TorchedVIP/Doom-Minibadge/gerbers/minibadge_doom/minibadge_doom.kicad_pcb

## KiCad design gerbers/minibadge_doom/minibadge_doom.kicad_pcb (2026-10-29)

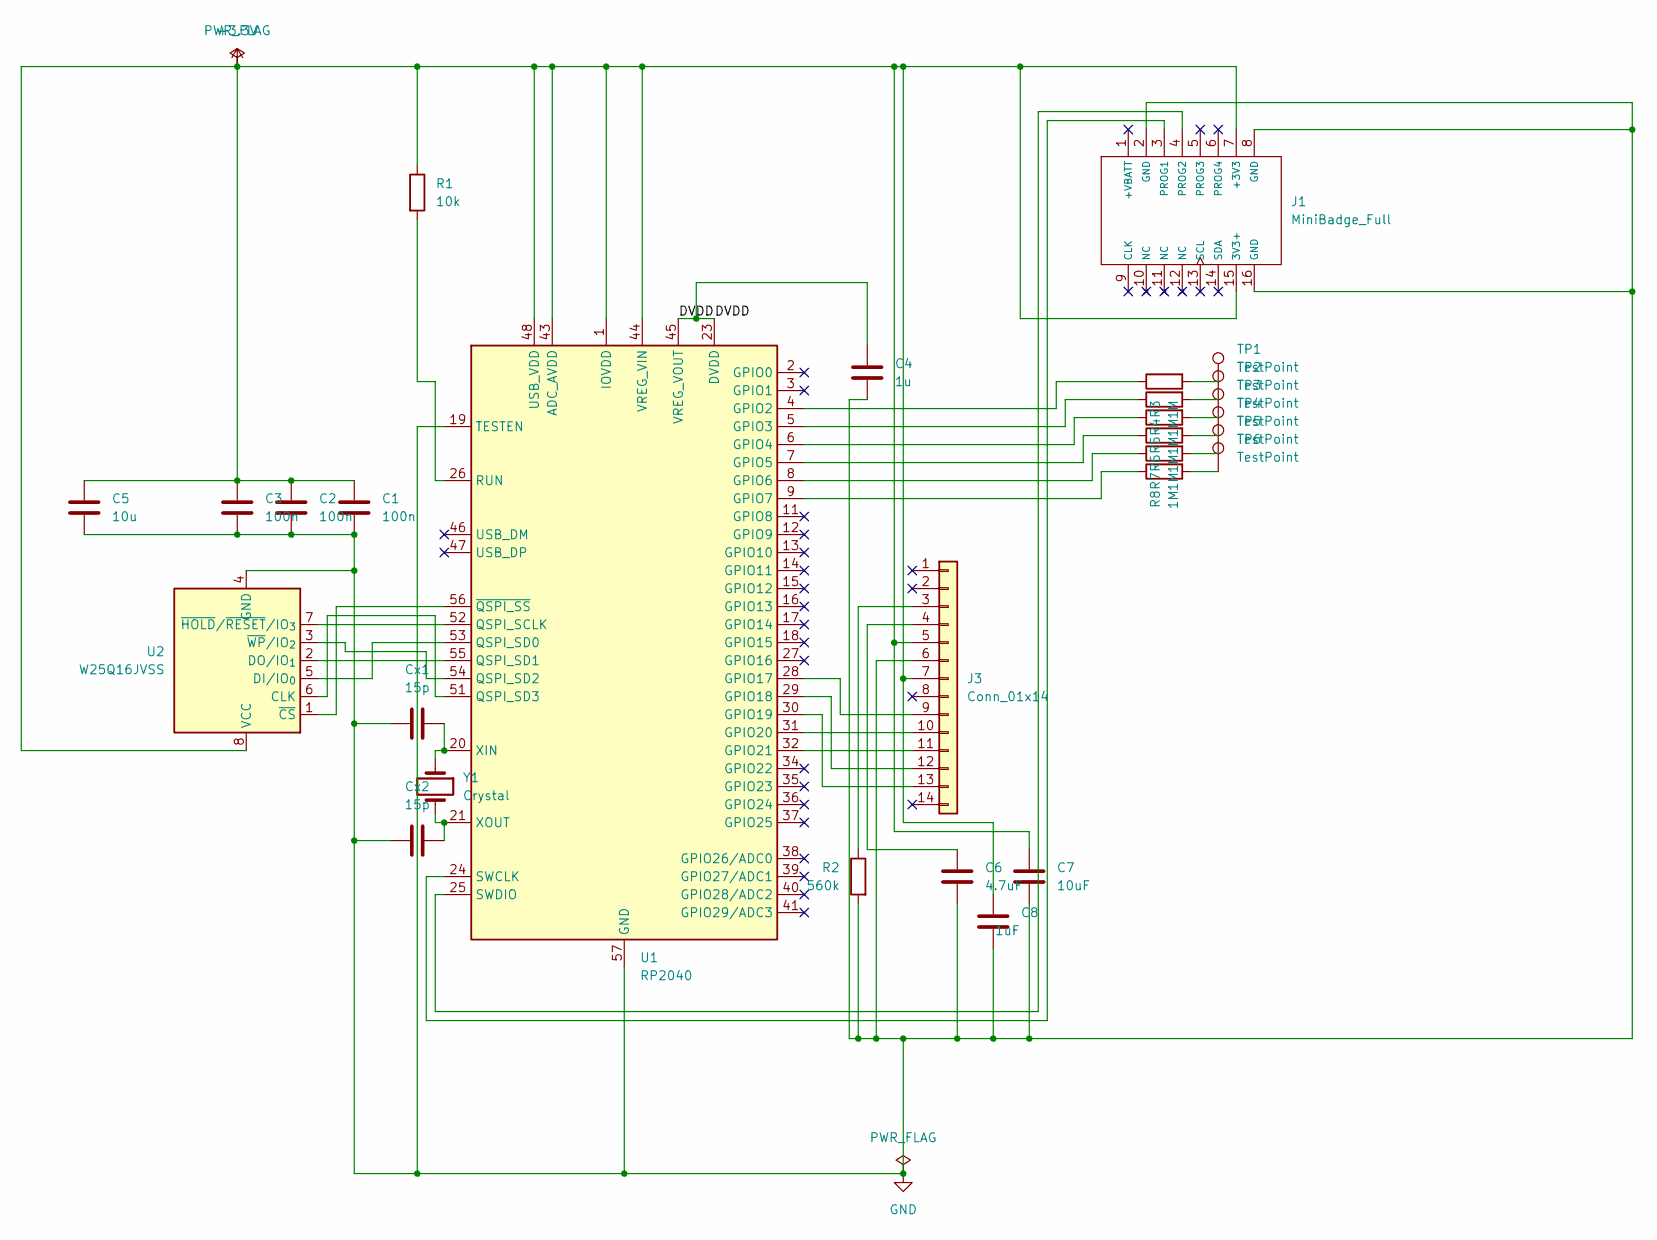
[picture p8: schematic minibadge_doom.kicad_sch]

Parts:
C1, C2, C3: 100n; C_0402_1005Metric
C4: 1u; C_0402_1005Metric
C5: 10u; C_0805_2012Metric
C6: 4.7uF; C_0402_1005Metric
C7: 10uF; C_0402_1005Metric
C8: 1uF; C_0402_1005Metric
Cx1, Cx2: 15p; C_0402_1005Metric
J1: MiniBadge_Full
J3: Conn_01x14; Hirose_FH12-14S-0.5SH_1x14-1MP_P0.50mm_Horizontal
R1: 10k; R_0402_1005Metric
R2: 560k; R_0402_1005Metric
R3, R4, R5, R6, R7, R8: 1M; R_0402_1005Metric
TP1, TP2, TP3, TP4, TP5, TP6: TestPoint; TestPoint_Pad_4.0x4.0mm
U1: RP2040; QFN-56-1EP_7x7mm_P0.4mm_EP3.2x3.2mm
U2: W25Q16JVSS; SOIC-8_3.9x4.9mm_P1.27mm
Y1: Crystal; Crystal_SMD_3215-2Pin_3.2x1.5mm

Connections:
+3.3V: C1.1, C2.1, C3.1, C5.1, C7.1, C8.1, J1.7 (+3V3), J1.15 (3V3+), J3.5, J3.7, R1.1, U1.1 (IOVDD), U1.10 (IOVDD), U1.22 (IOVDD), U1.33 (IOVDD), U1.42 (IOVDD), U1.43 (ADC_AVDD), U1.44 (VREG_VIN), U1.48 (USB_VDD), U1.49 (IOVDD), U2.8 (VCC)
/DVDD: C4.1, U1.23 (DVDD), U1.45 (VREG_VOUT), U1.50 (DVDD)
GND: C1.2, C2.2, C3.2, C4.2, C5.2, C6.2, C7.2, C8.2, Cx1.2, Cx2.2, J1.2 (GND), J1.8 (GND), J1.16 (GND), J3.6, R2.2, U1.19 (TESTEN), U1.57 (GND), U2.4 (GND)
unnamed: J1.3 (PROG1), U1.24 (SWCLK)
unnamed: J1.4 (PROG2), U1.25 (SWDIO)
unnamed: J3.3, R2.1
unnamed: C6.1, J3.4
unnamed: J3.9, U1.28 (GPIO17)
unnamed: J3.10, U1.31 (GPIO20)
unnamed: J3.11, U1.32 (GPIO21)
unnamed: J3.12, U1.29 (GPIO18)
unnamed: J3.13, U1.30 (GPIO19)
unnamed: R3.2, TP1.1 (1_1)
unnamed: R4.2, TP2.1 (1_1)
unnamed: R5.2, TP3.1 (1_1)
unnamed: R6.2, TP4.1 (1_1)
unnamed: R7.2, TP5.1 (1_1)
unnamed: R8.2, TP6.1 (1_1)
unnamed: R3.1, U1.4 (GPIO2)
unnamed: R4.1, U1.5 (GPIO3)
unnamed: R5.1, U1.6 (GPIO4)
unnamed: R6.1, U1.7 (GPIO5)
unnamed: R7.1, U1.8 (GPIO6)
unnamed: R8.1, U1.9 (GPIO7)
unnamed: U1.52 (QSPI_SCLK), U2.7 (~HOLD/~RESET/IO_{3})
unnamed: U1.53 (QSPI_SD0), U2.5 (DI/IO_{0})
unnamed: U1.55 (QSPI_SD1), U2.2 (DO/IO_{1})
unnamed: U1.54 (QSPI_SD2), U2.3 (~WP/IO_{2})
unnamed: U1.51 (QSPI_SD3), U2.6 (CLK)
unnamed: R1.2, U1.26 (RUN)
unnamed: Cx1.1, U1.20 (XIN), Y1.1
unnamed: Cx2.1, U1.21 (XOUT), Y1.2
unnamed: U1.56 (~QSPI_SS), U2.1 (~CS)

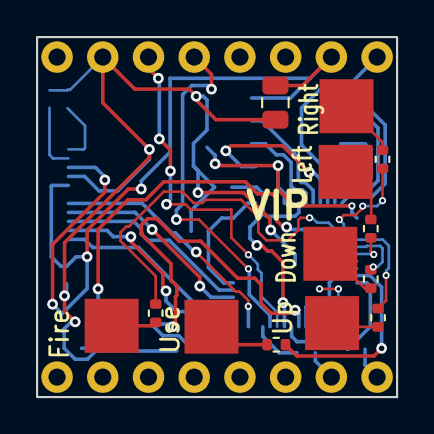
[picture p9: board minibadge_doom.kicad_pcb from above]

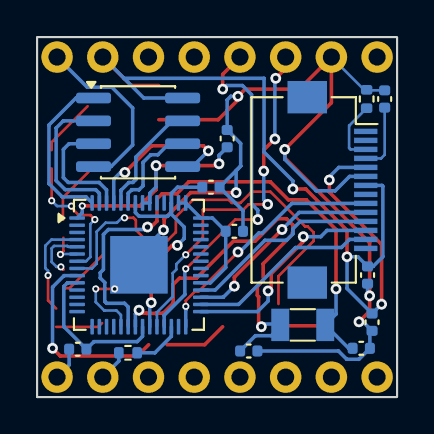
[picture p10: board minibadge_doom.kicad_pcb from below]

Board: 2 copper layers, 20.0 x 20.0 mm, 29 parts (15 on the bottom side), 33 nets.
